Edubgr/DigitalTwink-Proj2/problemas2_urdf_description/meshes/link1_1.stl

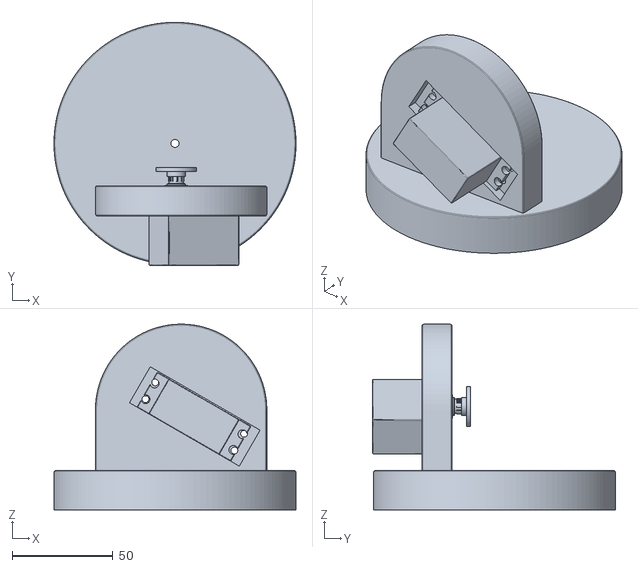
[picture p1: CAD file, 2026-09-18]
problemas2_urdf_description/meshes/link1_1.stl
120.0 x 120.6 x 92.0
