Edubgr/DigitalTwink-Proj2/problemas2_urdf_description/meshes/link3_1.stl

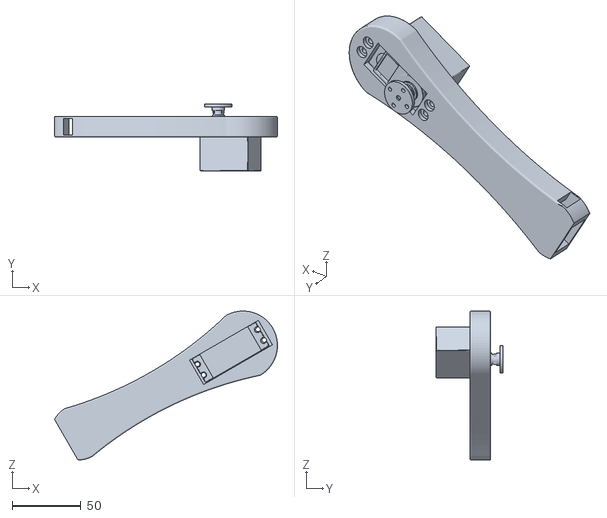
[picture p2: CAD file, 2026-09-18]
problemas2_urdf_description/meshes/link3_1.stl
162.0 x 48.6 x 108.1
