Edubgr/DigitalTwink-Proj2/problemas2_urdf_description/meshes/link2_1.stl

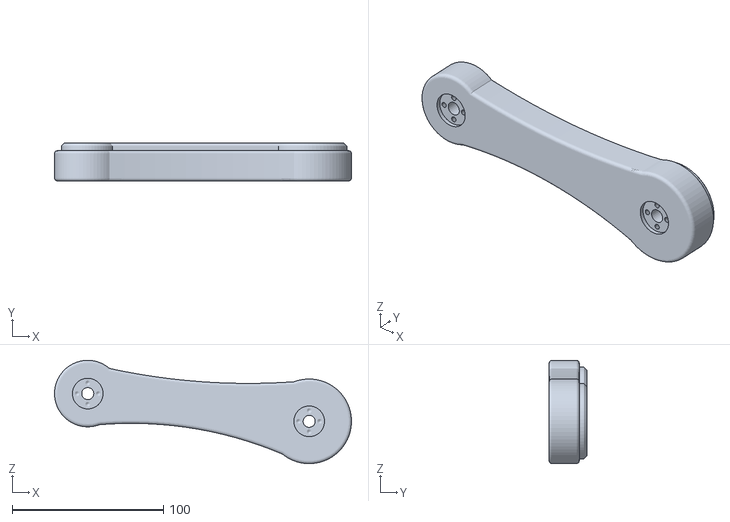
[picture p3: CAD file, 2026-09-18]
problemas2_urdf_description/meshes/link2_1.stl
196.5 x 25.0 x 68.3
