Edubgr/DigitalTwink-Proj2/problemas2_urdf_description/meshes/gripper_1.stl

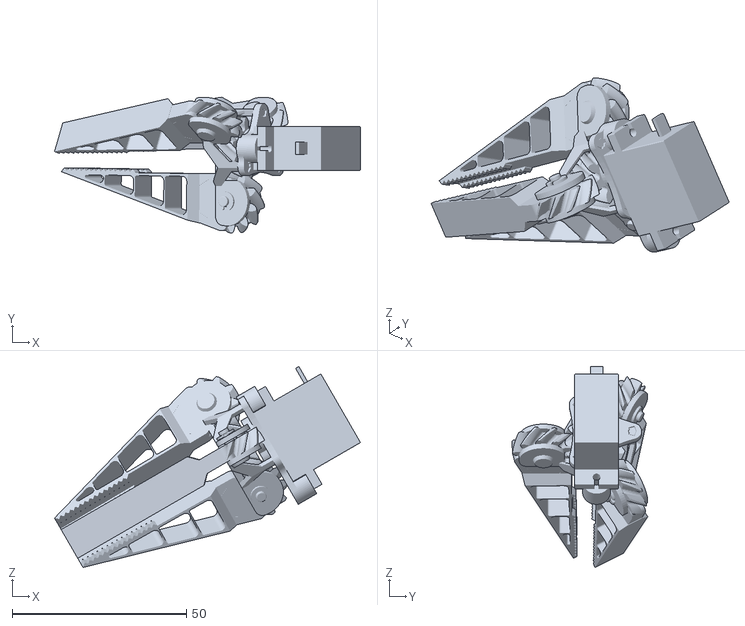
[picture p4: CAD file, 2026-09-18]
problemas2_urdf_description/meshes/gripper_1.stl
87.8 x 38.9 x 57.7
