Edubgr/DigitalTwink-Proj2/problemas2_urdf_description/meshes/base_link.stl

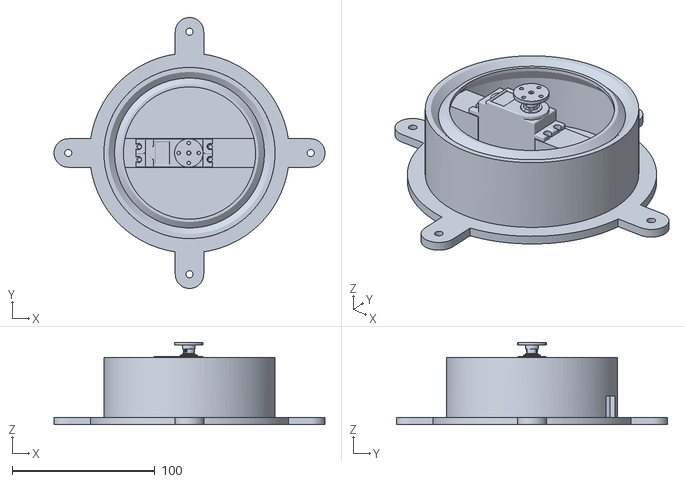
[picture p5: CAD file, 2026-09-18]
problemas2_urdf_description/meshes/base_link.stl
190.0 x 190.0 x 57.7
