Edubgr/DigitalTwink-Proj2/(commit log)

2026-09-18 feat: Digital Twin backend, frontend e MoveIt bridge
    - Backend FastAPI com controle PID para 3 motores
    - PID individual por motor com persistencia em JSON
    - Comunicacao serial ESP32 com reconexao automatica
    - Frontend com sliders, graficos e seletor de motor PID
    - Ponte HTTP para MoveIt (ROS 2)
    - 46 testes unitarios
    [base_link.stl, gripper_1.stl, joint_limits.yaml, link1_1.stl, link2_1.stl, link3_1.stl, materials.xacro, problemas2_urdf.xacro]
2026-09-18 feat: exibir KP/KI/KD de cada motor nos cards do dashboard
    - Cards MOTOR 01/02/03 agora mostram KP, KI, KD acima de POSITION
    - Feedback do backend inclui PID por motor
    - updatePidDisplay atualiza os cards a cada tick e ao receber pid_ack/pid_state
2026-09-18 style: KP/KI/KD em linha unica nos cards de motor
2026-09-18 fix: cards de motor nao ultrapassam o painel MOTOR DATA
    - overflow hidden no motor-grid e motor-card
    - padding e margens reduzidos para caber no painel
    - min-height: 0 para permitir encolhimento
2026-09-18 feat: filtro de media movel (window=8) no ADC
    - Classe MovingAverage com deque para eficiencia
    - Filtro aplicado em _process_data antes de salvar position
    - Constante FILTER_WINDOW=8 configuravel
    - 6 novos testes para MovingAverage
    - Resolve chattering do potenciometro
    [main.py, serial_manager.py, test_serial_manager.py]
2026-09-18 fix: tempo de estabilizacao para evitar chattering
    - Motor so recomeca apos N ciclos fora da zona de RELEASE_ERROR
    - RELEASE_ERROR aumentado de 1.5 para 2.0
    - SETTLING_CYCLES = 15 ciclos (~150ms a 10ms/ciclo)
    - Contador de settling resetado ao chegar no alvo ou no STOP
    [main.py]
2026-09-18 feat: boost anti-travamento para motores
    - Detecta travamento: motor nao se move por N ciclos com PWM aplicado
    - Aplica PWM_BOOST (120) por BOOST_DURATION (15 ciclos) para vencer atrito
    - STUCK_THRESHOLD (0.3 graus) para detectar ausencia de movimento
    - STUCK_CYCLES (20) antes de ativar boost
    - Reset dos contadores no STOP e ao chegar no alvo
    [main.py]
2026-09-18 fix: STUCK_THRESHOLD=0.1, PWM_BOOST=80
2026-09-18 fix: reduz FILTER_WINDOW de 8 para 3
    - Menos atraso no sinal (~30ms vs ~80ms)
    - Melhor precisao do PID
    - Ainda suaviza ruidos do potenciometro
    [main.py, serial_manager.py]
2026-09-18 fix: filtro derivativo no PID para evitar oscilacao
    - Filtro EMA no termo derivativo (alpha=0.2)
    - Suaviza o sinal Kd sem eliminar completamente a resposta
    - Resolve oscilacao de 255 para -255 causada por ruido no ADC
    - Teste de suavizacao do derivativo adicionado
    [pid.py, test_pid.py]
2026-09-18 refactor: remove filtro EMA e sistema de boost
    - Remove derivative_filter do PID (volta ao derivativo puro)
    - Remove constantes PWM_BOOST, BOOST_DURATION
    - Remove variaveis motor_prev_pos, motor_stuck_count, motor_boost_left
    - Remove logica de deteccao de travamento e boost
    - Simplifica control loop para PWM_MIN direto
2026-09-18 feat: slider de velocidade no painel MoveIt
    - Adiciona slider VELOCIDADE (0.1-1.0) no bloco MoveIt do urdf.html
    - Default 0.5 (29°/s) em vez de 0.3 fixo
    - Envia velocity_scale e acceleration_scale no requestPlan()
    - Acceleration proporcional à velocidade
2026-09-18 feat: slider de velocidade em rad/s, max 3.0
    - Slider mostra valor em rad/s em vez de fator de escala
    - Range 0.1 a 3.0 rad/s (era 0.1-1.0)
    - Step 0.1
2026-09-18 fix: grafico de posicoes no urdf - 4 bugs corrigidos
    - Import Chart.js: default -> named export (Chart.js 4.x ESM)
    - Eixo X: linear -> category (dados usam labels de string)
    - Layout grid: 0fr/180px em vez de display none/block (sem distorcao)
    - Canvas 3D: resizeRenderer() chamado ao toggle do grafico
    - Toggle: destrói chart ao ocultar, recria ao mostrar
2026-09-18 fix: import Chart.js dinâmico para não quebrar o 3D
    - Import estático crashava todo o módulo se Chart.js falhasse
    - Agora usa await import() com try/catch
    - 3D e WebSocket funcionam mesmo se Chart.js não carregar
    - Reverte grid para auto 1fr auto (funcional)
    - Reverte chart-wrap para display none/block (funcional)
2026-09-18 fix: chart.js via script tag UMD + initChart no reflow
    - Carrega Chart.js via <script src> UMD (global Chart) em vez de import ESM
    - initChart() agora roda dentro de requestAnimationFrame para garantir
    que o browser já reflowou display:block antes de medir o canvas
    - Remove import dinamico que falhava silenciosamente
2026-09-18 feat: grafico urdf igual ao dashboard - janela 10s fixa
    - Eixo X linear com janela deslizante de 10s (nao expande)
    - Dados em {x, y} em vez de arrays separados
    - Cores do dashboard (#f39c4a, #45d6c0, #e5c454)
    - Fundo #0c1016 igual ao dashboard
    - Planejado: 1px tracejado | Real: 2px solido
    - Remove state.chartTime/chartPlanned/chartActual
2026-09-18 feat: grafico mostra trajetoria planejada em tempo real
    - Amostra a trajetoria com sampleTrajectory() ao inves de goalQ
    - Eixo Y de -180 a 180 graus
    - Limpa trajetoria ao terminar playback ou toggle off
2026-09-18 feat: grafico inclui linhas de alvo (goalQ) em tempo real
    - 3 datasets adicionais 'alvo' com goalQ constante
    - Cor branca fraca, tracejado fino
    - Trajetoria planejada continua amostrada em tempo real
2026-09-18 feat: hold position - envia target continuamente apos trajetoria
    - holdTicker envia set_targets a 50Hz apos a trajetoria terminar
    - Para quando RUN desligado ou nova trajetoria inicia
2026-09-18 feat: botao Mirror - leitura do robô real sem comandos
    - Mirror: espelha encoders para 3D, sliders e grafico
    - Mutuamente exclusivo com RUN
    - Para hold ticker e trajetorias ao ativar
    - Estilo laranja (vs verde do RUN)
2026-09-18 fix: mirror desabilita execucao, sliders e linhas do grafico
    - Esconde linhas tracejadas (planejado) no grafico
    - Desabilita botao Executar e sliders das juntas
    - Estilo visual opaco nos sliders desabilitados
2026-09-18 fix: salvar pose captura posicao atual (state.q) em vez de goalQ
2026-09-18 fix: mirror bloqueia play individual de poses
2026-09-18 feat: UI improvements - English translation, pose rename, layout fixes
    - Translate all Portuguese UI texts to English (labels, status, errors, chart)
    - Add double-click rename for saved poses
    - Fix panel border clipping by moving overflow:hidden to viewer only
    - Fix panel-head padding (12px 16px) for consistent horizontal spacing
    - Move Workspace/Trail buttons to legend bar below 3D viewer
    - Restructure RUN/MIRROR as grid 1fr 1fr below Execute/Home
    - Fix PWM chip, velocity label, DURATION clipping
    - Rename CSS classes: .limites->.limits, .fora->.outside, data-mode->position
